verylowfreq/suzuduino-uno-v1/docs/suzuduino-uno-v1b_ShortGuide_02.pdf

# Suzuduino UNO V1b

## 組み立て例

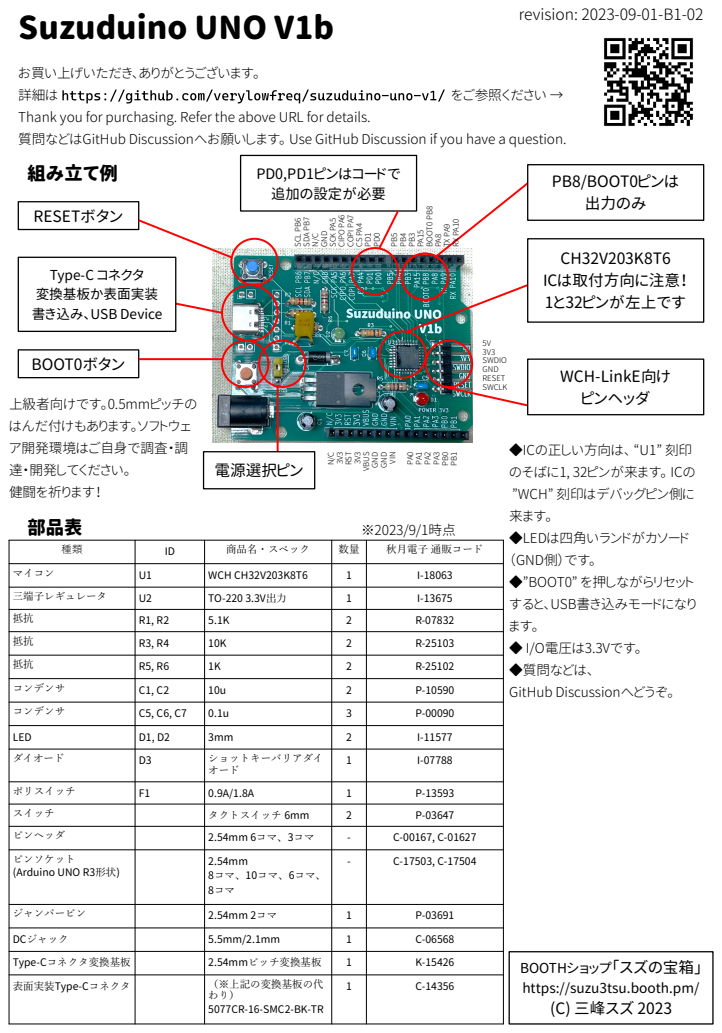
[picture p3: page 1]

詳細は https://github.com/verylowfreq/suzuduino-uno-v1/ をご参照ください →
Thank you for purchasing. Refer the above URL for details.
質問などはGitHub Discussionへお願いします。 Use GitHub Discussion if you have a question.

種類 | ID | 商品名・スペック | 数量 | 秋月電子 通販コード

マイコン | U1 | WCH CH32V203K8T6 | 1 | I-18063
三端子レギュレータ | U2 | TO-220 3.3V出力 | 1 | I-13675
抵抗 | R1, R2 | 5.1K | 2 | R-07832
抵抗 | R3, R4 | 10K | 2 | R-25103
抵抗 | R5, R6 | 1K | 2 | R-25102
コンデンサ | C1, C2 | 10u | 2 | P-10590
コンデンサ | C5, C6, C7 | 0.1u | 3 | P-00090
LED | D1, D2 | 3mm | 2 | I-11577
ダイオード | D3 | ショットキーバリアダイ オード | 1 | I-07788

ポリスイッチ | F1 | 0.9A/1.8A | 1 | P-13593
スイッチ | | タクトスイッチ 6mm | 2 | P-03647
ピンヘッダ | | 2.54mm 6コマ、3コマ | - | C-00167, C-01627
ピンソケット (Arduino UNO R3形状) | | 2.54mm 8コマ、10コマ、6コマ、 8コマ | - C-17503, C-17504

ジャンパーピン | | 2.54mm 2コマ | 1 | P-03691
DCジャック | | 5.5mm/2.1mm | 1 | C-06568
Type-Cコネクタ変換基板 | | 2.54mmピッチ変換基板 | 1 | K-15426 | BOOTHショップ「スズの宝箱」 https://suzu3tsu.booth.pm/(C) 三峰スズ 2023
表面実装Type-Cコネクタ | | （※上記の変換基板の代 わり） 5077CR-16-SMC2-BK-TR | 1 | C-14356
