verylowfreq/suzuduino-uno-v1/drawings/suzuduino-uno-v1b_schematic.pdf

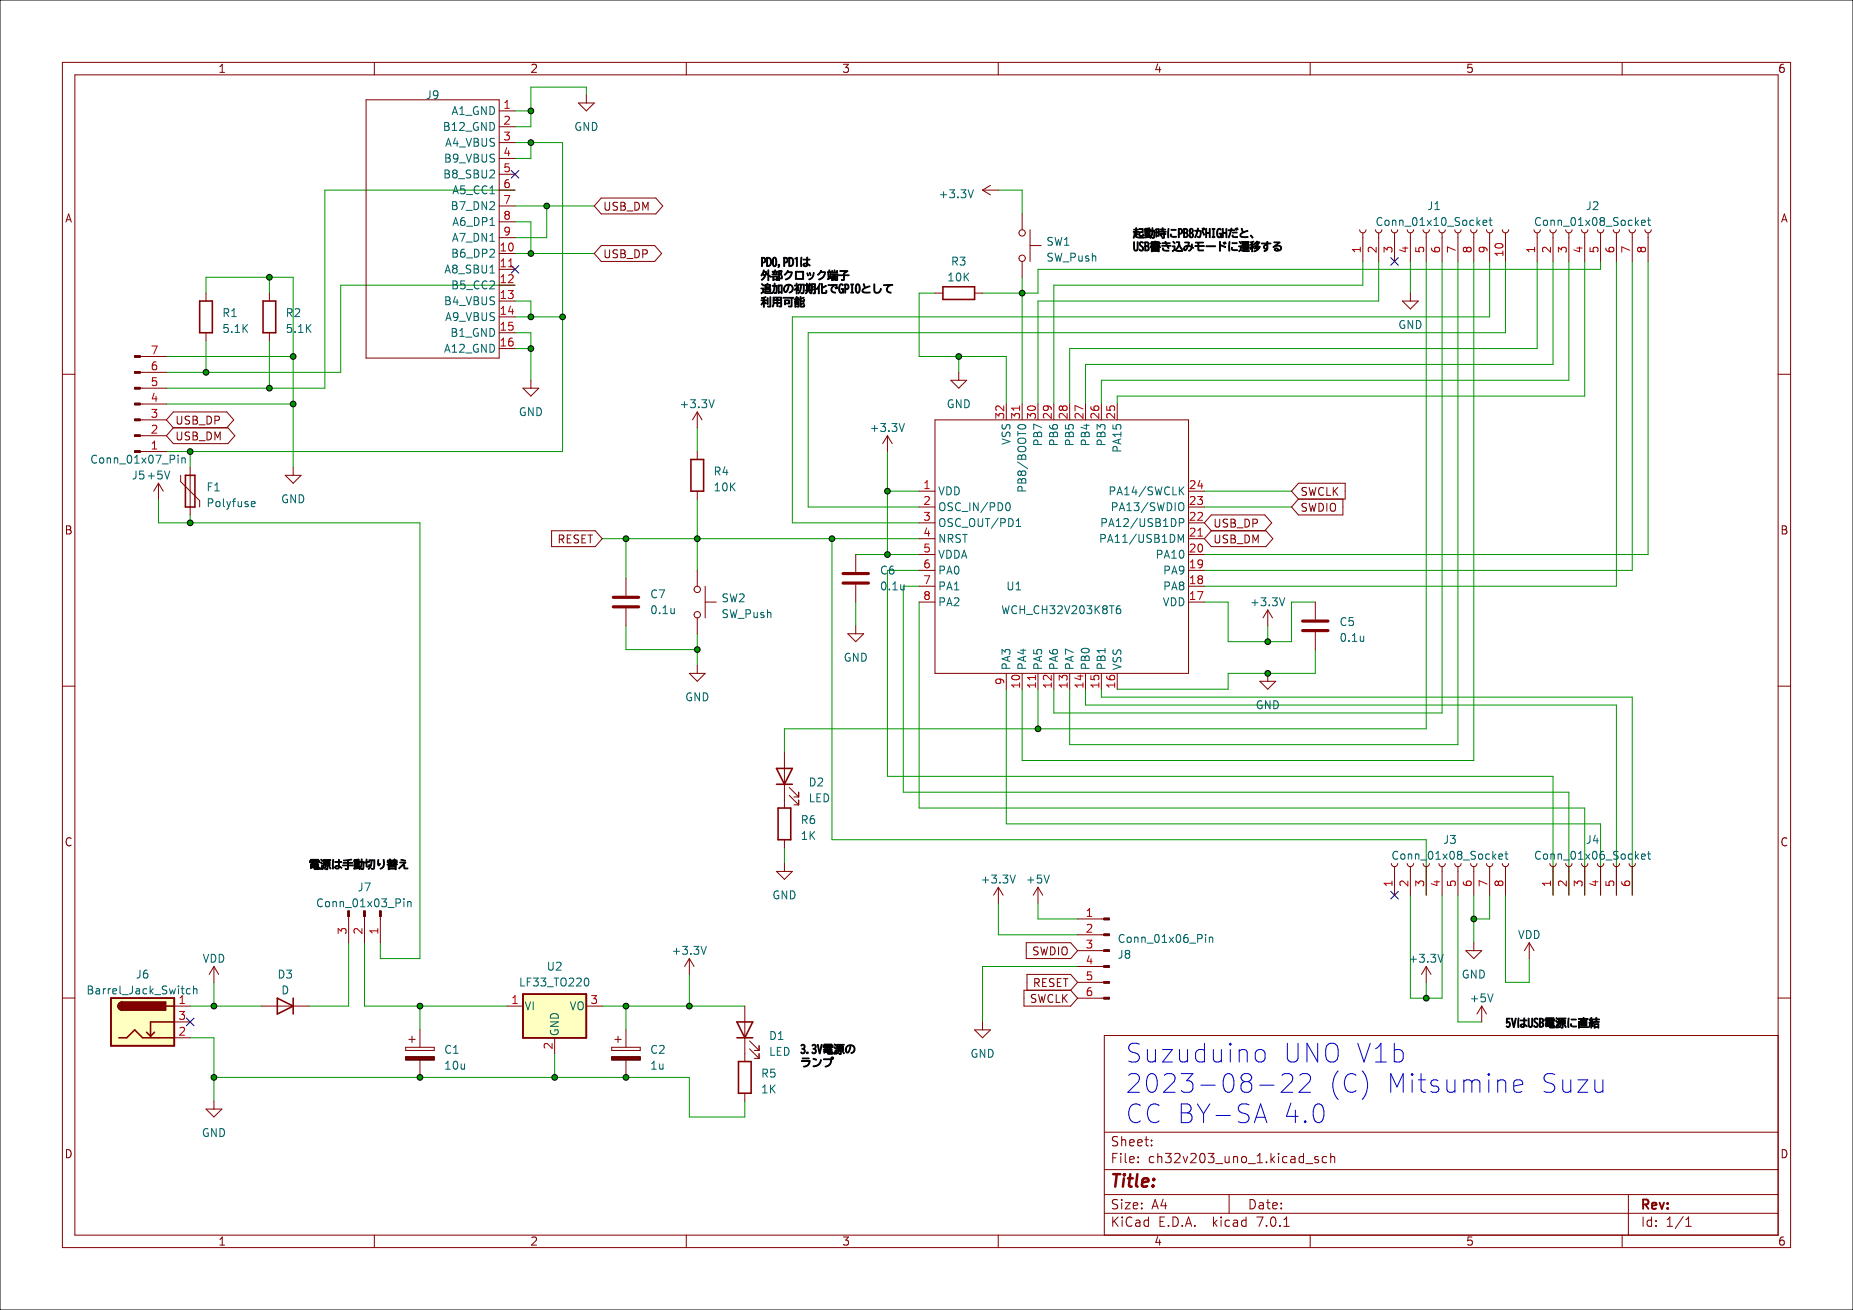
[picture p4: page 1]
