verylowfreq/suzuduino-uno-v1/drawings/suzuduino-uno-v1a_schematic.pdf

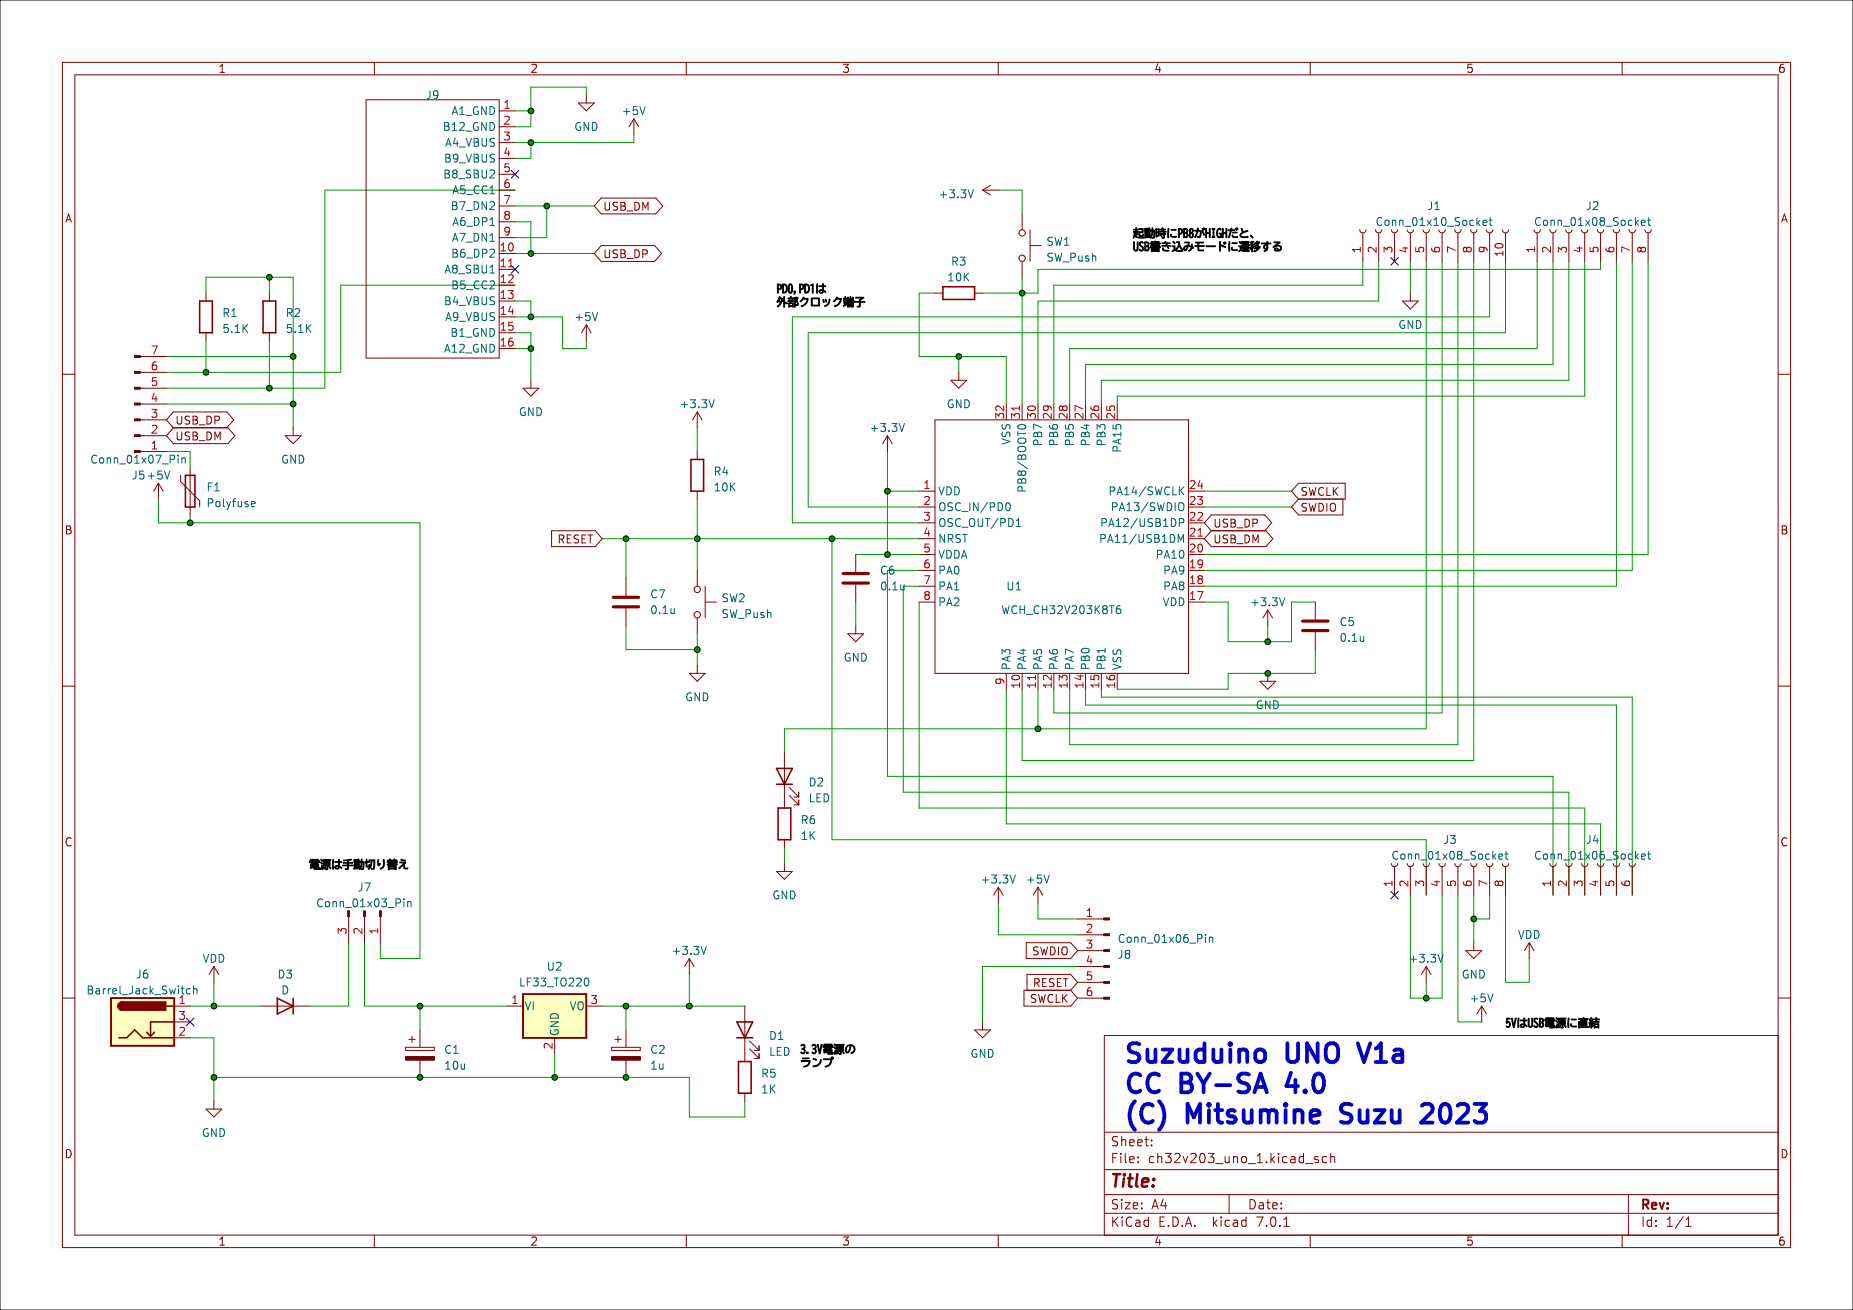
[picture p5: page 1]
