verylowfreq/suzuduino-uno-v1/docs/suzuduino-uno-v1a_ShortGuide.pdf

# Suzuduino UNO V1a

## 組み立て例

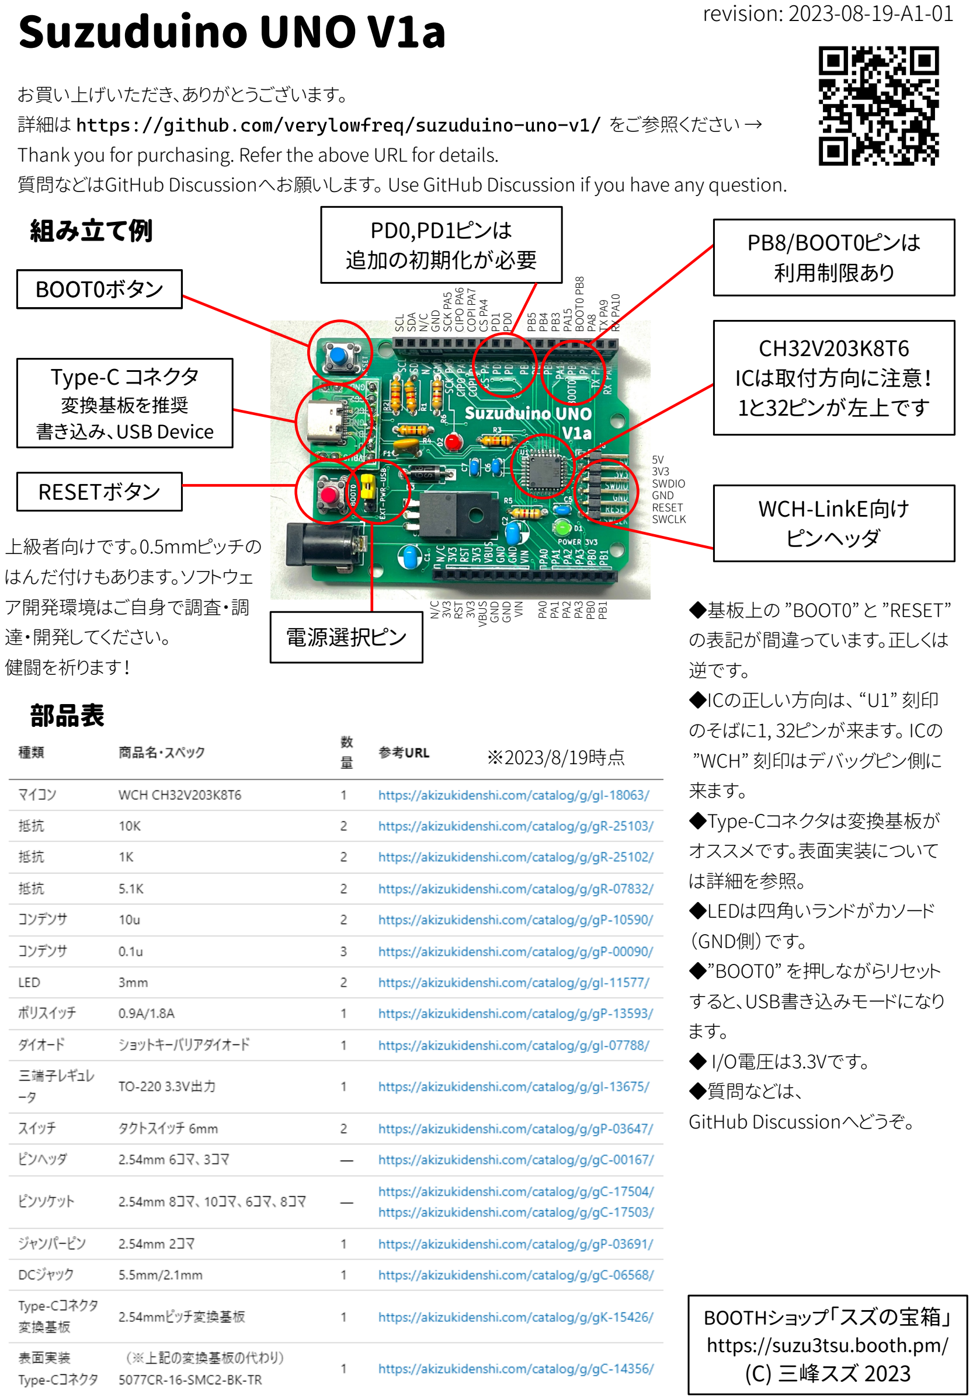
[picture p6: page 1]

お買い上げいただき、ありがとうございます。

詳細は https://github.com/verylowfreq/suzuduino-uno-v1/ をご参照ください →
Thank you for purchasing. Refer the above URL for details.
質問などはGitHub Discussionへお願いします。 Use GitHub Discussion if you have any question.

revision: 2023-08-19-A1-01

◆基板上の ”BOOT0” と ”RESET”
の表記が間違っています。正しくは
逆です。
◆ICの正しい方向は、 “U1” 刻印
のそばに1, 32ピンが来ます。 ICの
”WCH” 刻印はデバッグピン側に
来ます。
◆Type-Cコネクタは変換基板が
オススメです。表面実装について
は詳細を参照。
◆LEDは四角いランドがカソード
（GND側）です。
◆”BOOT0” を押しながらリセット
すると、USB書き込みモードになり
ます。
◆ I/O電圧は3.3Vです。
◆質問などは、
GitHub Discussionへどうぞ。

## 部品表

※2023/8/19時点

BOOT0ボタン

RESETボタン

CH32V203K8T6
ICは取付方向に注意！
1と32ピンが左上です

WCH-LinkE向け
ピンヘッダ

PB8/BOOT0ピンは
利用制限あり

Type-C コネクタ
変換基板を推奨
書き込み、USB Device

電源選択ピン

PD0,PD1ピンは
追加の初期化が必要

N/C
3V3

RST
3V3

VBUS
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
SWDIO
GND
RESET
SWCLK

SCL

SDA
N/C

GND

SCK PA5

CIPO PA6
COPI PA7
CS PA4

PD1

PD0
PB5

PB4

PB3

PA15

BOOT0 PB8

PA8

TX PA9

RX PA10

BOOTHショップ「スズの宝箱」
https://suzu3tsu.booth.pm/
(C) 三峰スズ 2023

上級者向けです。0.5mmピッチの
はんだ付けもあります。ソフトウェ
ア開発環境はご自身で調査・調
達・開発してください。
健闘を祈ります！
